codeshelf/LEDCON.PCB/README.md

LEDCON.PCB
==========

LED Controller PCB design files (no production files)
