codeshelf/LEDCON.PCB/LEDCon Design Files/LEDLayout.stl

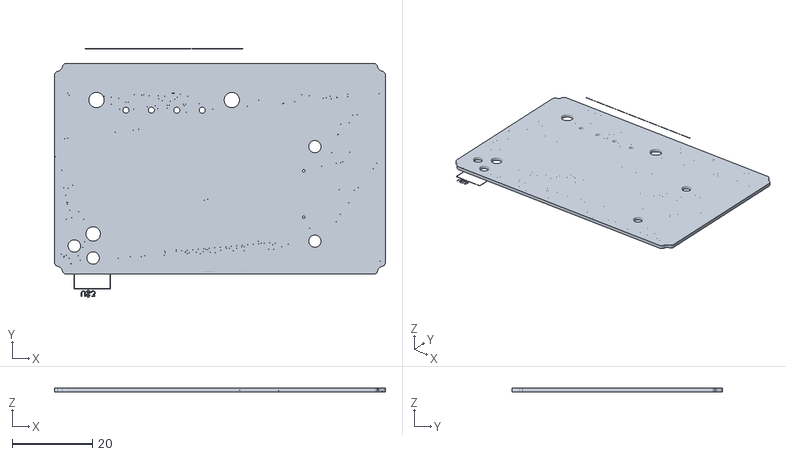
[picture p1: CAD file, 2015-01-04]
LEDCon Design Files/LEDLayout.stl
82.7 x 62.2 x 1.07
