codeshelf/LEDCON.PCB/LEDCon Design Files/LEDCON.PCB.brd

## EAGLE design LEDCon Design Files/LEDCON.PCB.brd (2015-02-21)

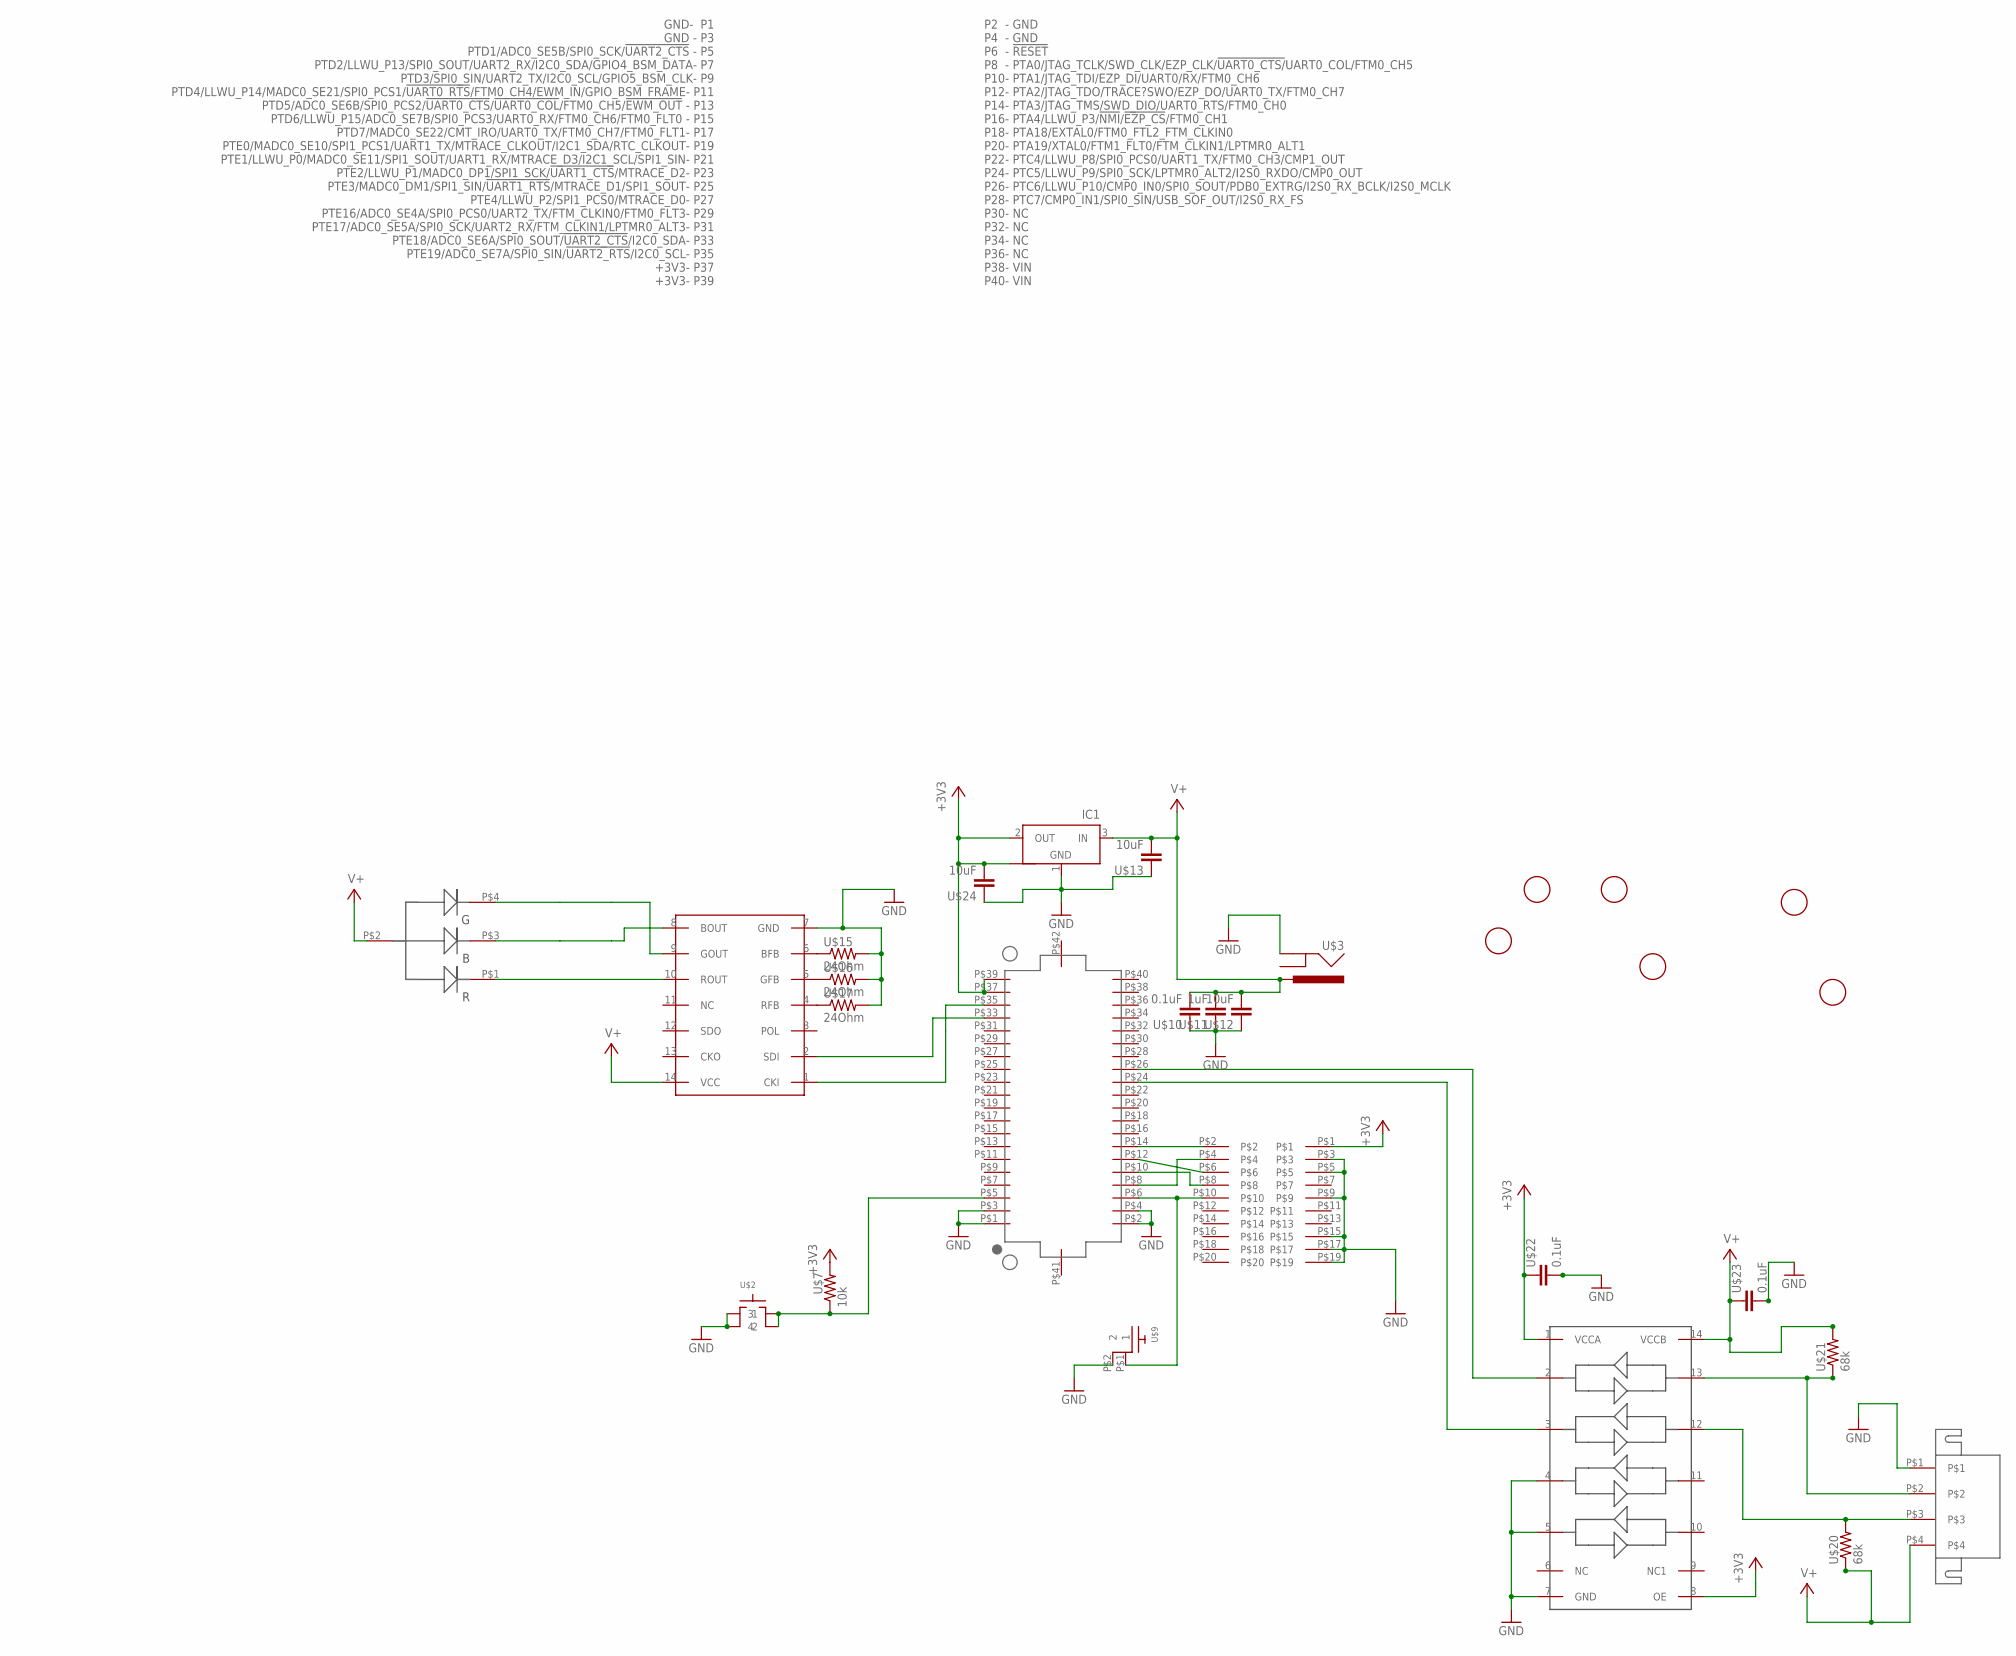
[picture p2: schematic LEDCON.PCB.sch]

Parts:
IC1: NCP1117ST33T3G_1; SOT223
U$1: MATE-N-LOK_643230-1
U$2: SWITCH-TACTILE; ESWITCH-TL3301PF
U$3: BARREL_CUI_PJ-002A
U$4: DF12_F
U$5: RGLBED; PLCC4_SMALL
U$6: TXB0104; PW_R-PDSO-G14
U$7: 10k; RF-C0805
U$8: WS2801; SO14
U$9: RA_BUTTON
U$10, U$22, U$23: 0.1uF; C0805
U$11: 1uF; C0805
U$12, U$13, U$24: 10uF; C0805
U$14, U$18, U$25, U$26, U$27, U$28: FIDUCIAL; FIDUCIAL_1MM
U$15, U$16, U$17: 24Ohm; RF-C0805
U$19: 2X10JTAG
U$20, U$21: 68k; RF-C0805

Connections:
+3V3: IC1.2 (OUT), IC1.4 (OUT1), U$4.P$37 (+3V3), U$4.P$39 (+3V3), U$6.1 (VCCA), U$6.8 (OE), U$7.2, U$19.P$1, U$22.1, U$24.2
CLK_5V: U$1.P$3, U$6.12, U$20.2
DAT_5V: U$1.P$2, U$6.13, U$21.1
GND: IC1.1 (GND), U$1.P$1, U$2.1, U$2.2, U$3.P$2 (GND), U$4.P$1 (GND), U$4.P$2 (GND), U$4.P$3 (GND), U$4.P$4 (GND), U$6.4, U$6.5, U$6.7 (GND), U$8.7 (GND), U$9.P$2 (2), U$10.1, U$11.1, U$12.1, U$13.1, U$15.2, U$16.2, U$17.2, U$19.P$3, U$19.P$5, U$19.P$9, U$19.P$15, U$19.P$17, U$19.P$19, U$22.2, U$23.2, U$24.1
unnamed: U$4.P$26 (PTC6/LLWU_P10/CMP0_IN0/SPI0_SOUT/PDB0_E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), U$6.2
unnamed: U$4.P$24 (PTC5/LLWU_P8/SPI0_PCS0/UART1_TX/FTM0_CH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), U$6.3
unnamed: U$4.P$6 (!RESET), U$9.P$1 (1), U$19.P$10
unnamed: U$5.P$4 (GREEN), U$8.9 (GOUT)
unnamed: U$5.P$3 (BLUE), U$8.8 (BOUT)
unnamed: U$4.P$14 (PTA3/JTAG_TMS/SWD_DIO/UART0_RTS/FTM0_CH0), U$19.P$2
unnamed: U$5.P$1 (RED), U$8.10 (ROUT)
unnamed: U$4.P$12 (PTA2/JTAG_TDO/TRACE?SWO/EZP_DO/UART0_TX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), U$19.P$6
unnamed: U$4.P$33 (PTE18/ADC0_SE6A/SPI0_SOUT/!UART2_CTS!/I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), U$8.2 (SDI)
unnamed: U$8.6 (BFB), U$15.1
unnamed: U$8.5 (GFB), U$16.1
unnamed: U$8.4 (RFB), U$17.1
unnamed: U$4.P$35 (PTE19/ADC0_SE7A/SPI0_SIN/!UART2_RTS!/I2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), U$8.1 (CKI)
unnamed: U$4.P$8 (PTA0/JTAG_TCLK/SWD_CLK/EZP_CLK/!UART0_C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), U$19.P$4
unnamed: U$4.P$10 (PTA1/JTAG_TDI/EZP_DI/UART0/RX/FTM0_CH6), U$19.P$8
unnamed: U$2.3, U$2.4, U$4.P$5 (PTD1/ADC0_SE5B/SPI0_SCK/!UART2_CTS), U$7.1
V+: IC1.3 (IN), U$1.P$4, U$3.P$1 (PWR), U$5.P$2 (ANODE), U$6.14 (VCCB), U$8.14 (VCC), U$10.2, U$11.2, U$12.2, U$13.2, U$20.1, U$21.2, U$23.1

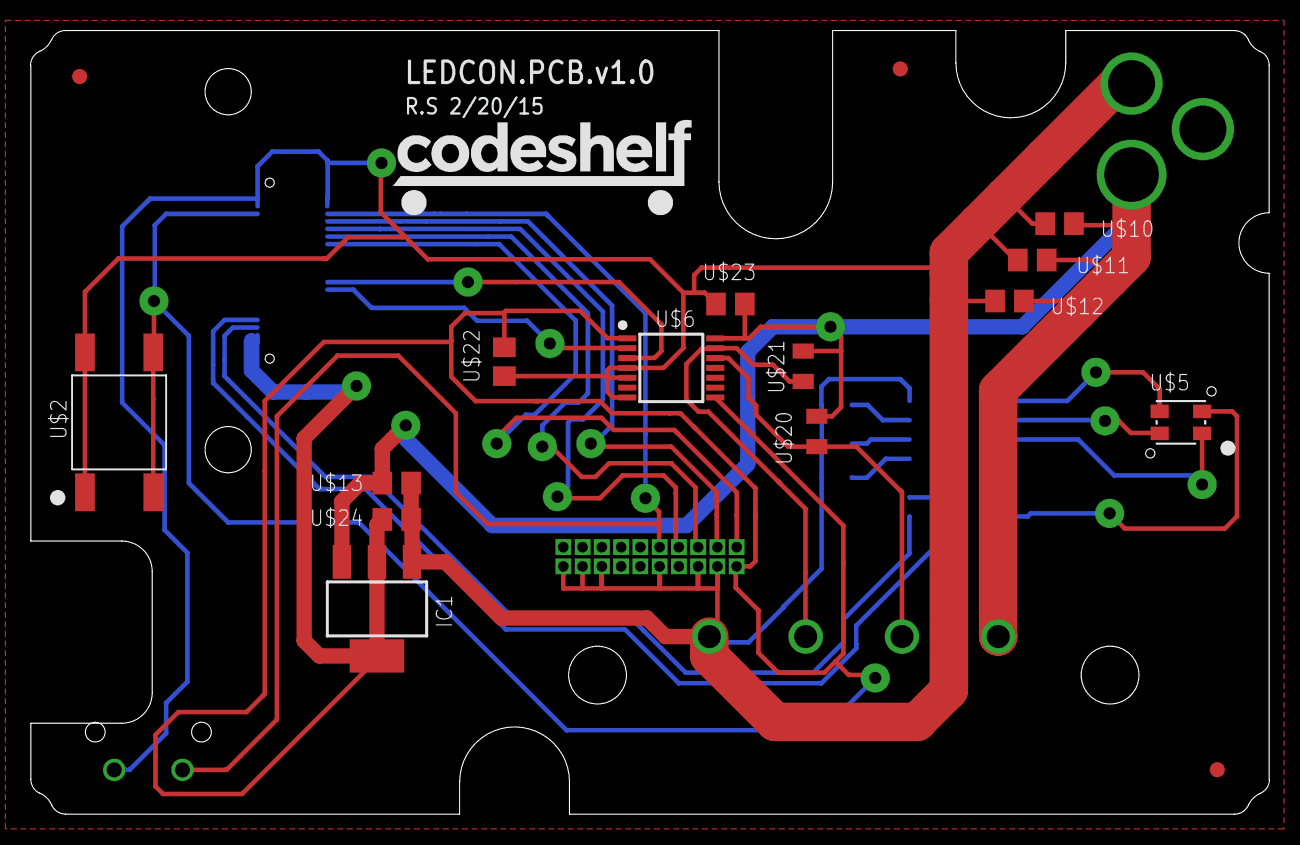
[picture p3: board LEDCON.PCB.brd from above]

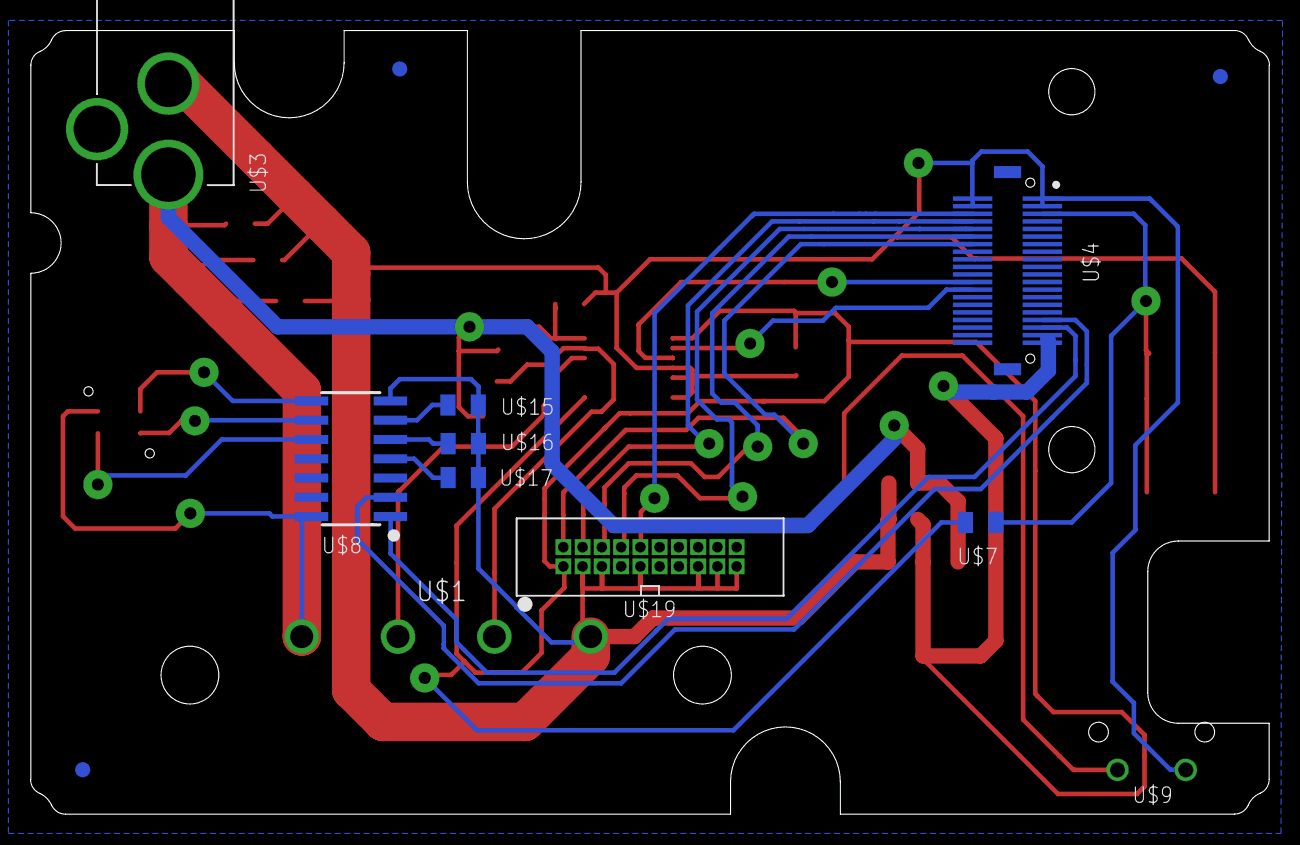
[picture p4: board LEDCON.PCB.brd from below]

Board: 2 copper layers, 81.7 x 51.7 mm, 29 parts (13 on the bottom side), 21 nets.
