codeshelf/LEDCON.PCB/(commit log)

2015-01-04 Finishing prototype routing
    Still need LED information.
    [LEDLayout.brd, LEDLayout.sch, LEDLayout.step, LEDLayout.stl]
2015-01-05 Finished routing 1st prototype
    Added WS2801, choice resistors & finished routing
    [LEDLayout.brd, LEDLayout.sch]
2015-01-13 Added JTAG header, fixed data / clock switch
    Moved TXB0104 to front side
    [LEDLayout.brd, LEDLayout.sch]
2015-01-15 Prototype 3
    Added filter caps and output data /clk pullups
    [LEDLayout.brd, LEDLayout.sch]
2015-01-23 Prototype 4
    Fixed LED, removed jumpers, fixed JTAG traces and added RA reset button
    [LEDLayout.brd, LEDLayout.sch]
2015-02-19 Prototype 5
    Added Vreg, caps, fixed LED, assigned values & PNs, removed 0402
    footprints. Pending exporting of production files
    [LEDLayout.brd, LEDLayout.sch]
2015-02-20 LEDCON.PCB.v1.0 pre-release
    Pending checklist processing.
    Fixed reset switch orientation, added planes, silk screen labelling,
    added all part numbers, exported production files, added BOM, ECO and
    FAB notes.
    [LEDCON.PCB.BOM.xlsx, LEDCON.PCB.ECO.xlsx, LEDCON.PCB.brd, LEDCON.PCB.csv, LEDCON.PCB.sch, LEDCON.PCB_centroid.csv, LEDLayout.brd, LEDLayout.step]
2015-02-21 LEDCON.PCB.v1.0
    Everything done. Release version.
    [LEDCON.PCB.BOM.xlsx, LEDCON.PCB.ECO.xlsx, LEDCON.PCB.brd, LEDCON.PCB.csv, LEDCON.PCB.sch, LEDCON.PCB_centroid.csv]
